filipnet/aquarium/src/config.h

#define I2C_ADDRESS_BME280 0x76
#define RELAY_NIGHTLIGHT D5
#define RELAY_DAYLIGHT D6
#define RELAY_AIRPUMP D3
#define RELAY_FILTER D0
#define WATERTEMP_SENSOR D7 // 5 V with 4.7 kΩ pullup required (internal pullup not sufficient)
#define SENSOR_INTERVALL 60000
#define HEARTBEAT_INTERVALL 512000
