filipnet/aquarium/(commit log)

2022-06-12 Extension by a 4-port relay
2025-09-06 Deprecate repository in favor of ESPHome version
    This repository is no longer actively maintained.
    The complete logic has been rebuilt with ESPHome using the same hardware and sensors.
    For further information and the updated implementation, please visit:
    https://www.filipnet.de/esphome-smart-devices
